gom9000/xp-bus-simplebus/interface-pic16f6x8/README.md

# xpSimpleBUS Interface to PIC16F6x8
Hardware and software to connect xpSimpleBUS to PIC16f6x8.

overview

## Hardware
[Hardware](hardware) to connect xpSimpleBUS to PIC16f6x8 through the *A/D Mux Bridge* board.

## Software
*todo...*
