gom9000/xp-bus-simplebus/interface-rpi/README.md

# xpSimpleBUS Interface to RPi
Software driver to connect xpSimpleBUS to RaspberryPi through the *A/D Mux Bridge* board.

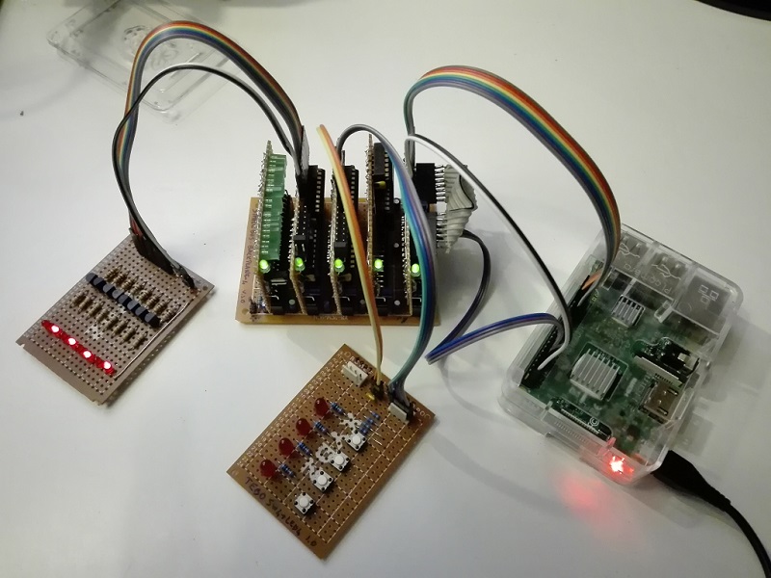
[picture p2: interface-rpi/simplebus-interface-rpi.jpg]
overview


## Software
* **xpSimpleBUS Diagnostic Tool**
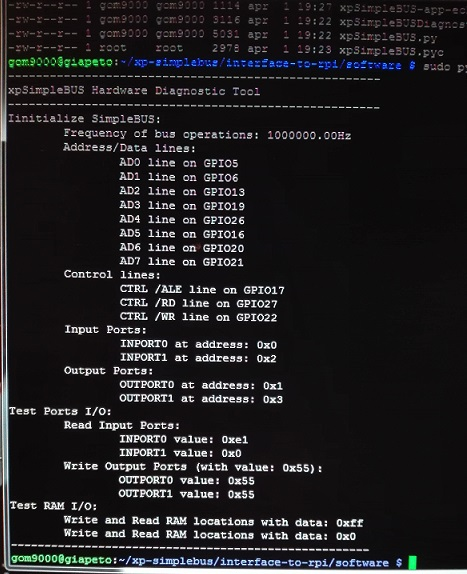
[picture p3: interface-rpi/simplebus-interface-rpi-diagnostic.jpg]
>
