gom9000/xp-bus-simplebus/bridge/README.md

# xpSimpleBUS Bridge
Schematics and pcb of the hardware bridges to interface xpSimpleBUS to a CPU or other BUS systems.

## Contents
* [A/D Mux Bridge](simplebus-bridge-admux) xpSimpleBUS bridge to an external 8-bit BUS
