gom9000/xp-bus-simplebus/device/README.md

# xpSimpleBUS Device
Schematics and pcb of the xpSimpleBUS devices hardware.

## Contents
* [Input Port](simplebus-device-input-port) 8-bit input port with selectable address
* [Output Port](simplebus-device-output-port) 8-bit latched output port with selectable address
* [128x8-Bytes Static RAM](simplebus-device-sram-128bytes) 128x8-Bytes Static RAM
