gom9000/xp-bus-simplebus/system/README.md

# xpSimpleBUS System
Schematics and pcb of the xpSimpleBUS system backplanes and activity-monitor hardware.

## Contents
* [Backplane 4+1 slots](simplebus-system-backplane-4) 4+1 slots backplane
* [Activity Monitor](simplebus-system-activity-monitor) monitor/test board for bus pins activity
* [2-Slot BUS Expansion](simplebus-system-bus-expansion) 2-slot bus expansion board
