gom9000/xp-bus-simplebus/bridge/simplebus-bridge-admux/README.md

# *A/D Mux Bridge* Board
Bridge board to connect the xpSimpleBUS to an external 8-bit BUS with multiplexed address and data lines.

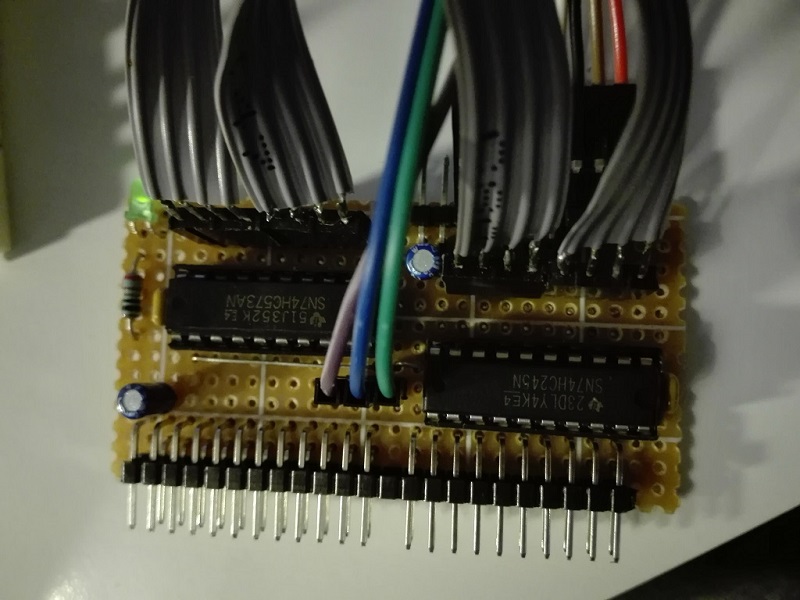
[picture p6: bridge/simplebus-bridge-admux/simplebus-bridge-admux_built.jpg]
board-built


## Schematic
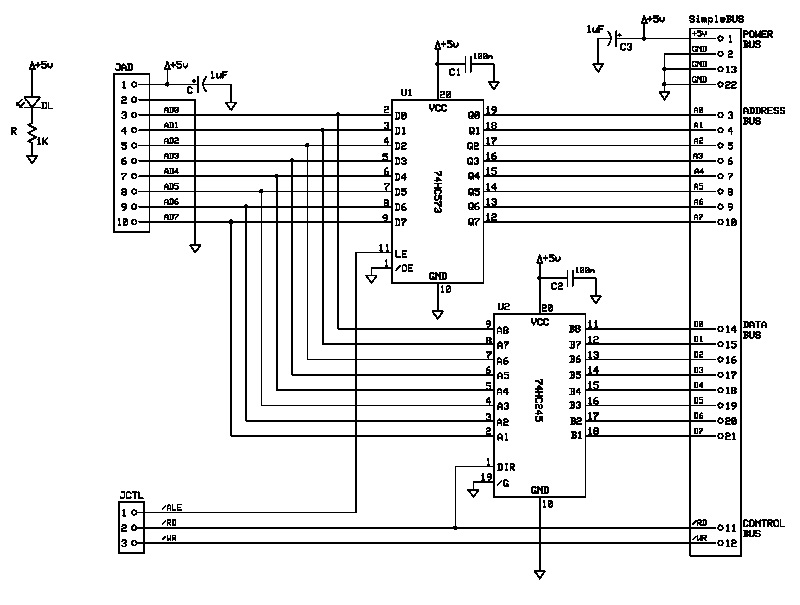
[picture p7: bridge/simplebus-bridge-admux/simplebus-bridge-admux_sch.jpg]
board-schematic


## PCB Layout
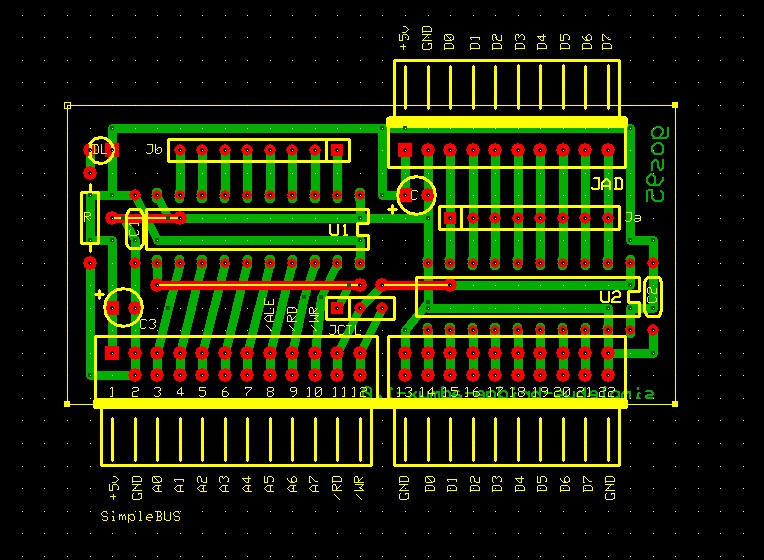
[picture p8: bridge/simplebus-bridge-admux/simplebus-bridge-admux_pcb.jpg]
board-pcb


## Bill of Materials
- [x] paperboard 5x7cm
- [x] 1 x bulk capacitors (tantalum) 1uF 16V
- [x] power activity led green 3mm
- [x] led current limiter resistor 1Kohm
- [x] SimpleBUS DIL 24-pin right-angle header

- [x] AD-BUS SIL 10-pin header
- [x] CTRL-BUS SIL 3-pin header
- [x] IC-logic 74HC573, 74HC245
