gom9000/xp-bus-simplebus/device/simplebus-device-output-port/README.md

# *Output Port* Board
8-bit latched output port with selectable address (by a 8-jumper row) in a range of 00H-07H.

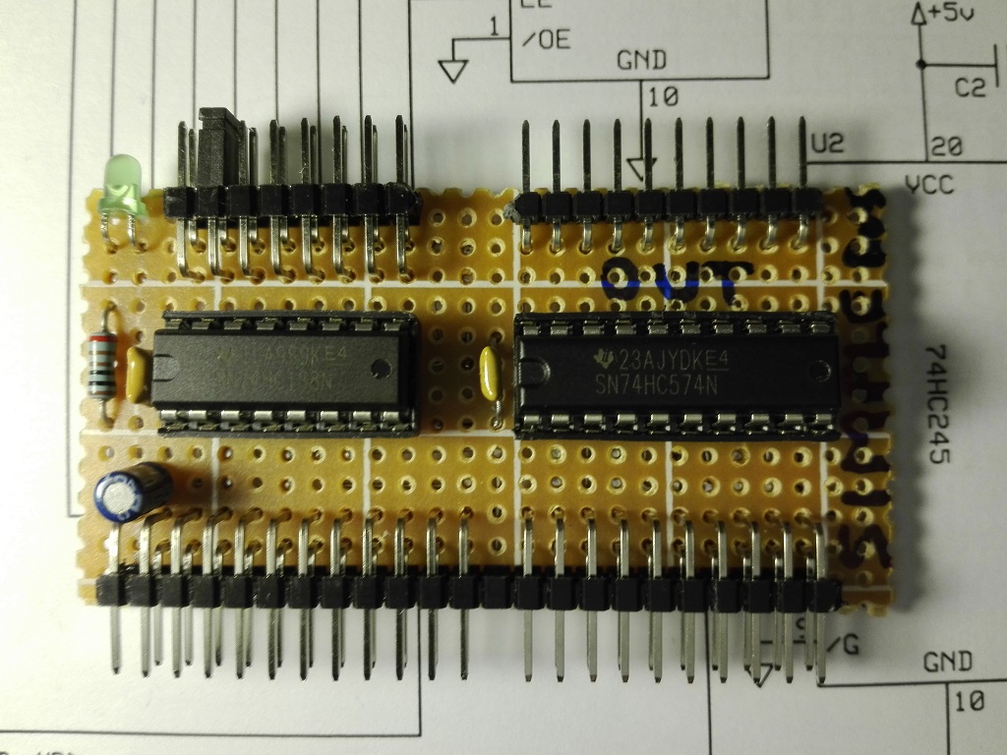
[picture p12: device/simplebus-device-output-port/simplebus-device-output-port_built.jpg]
board-built


## Schematic
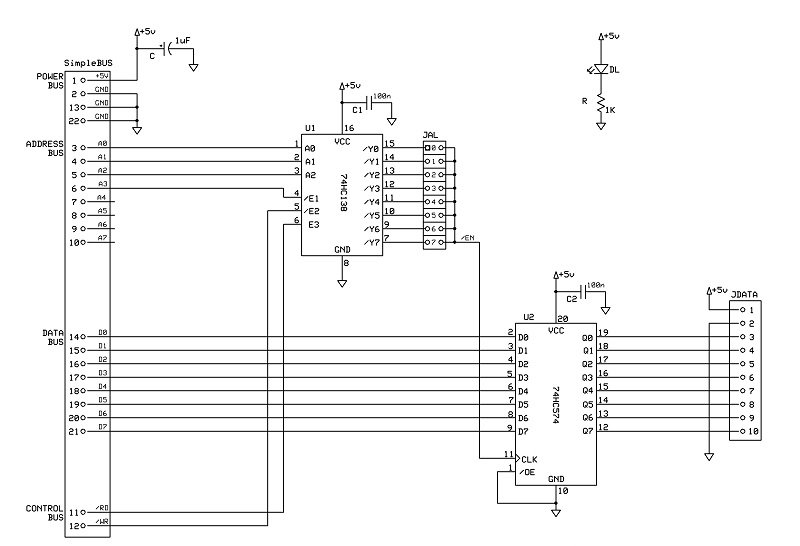
[picture p13: device/simplebus-device-output-port/simplebus-device-output-port_sch.jpg]
board-schematic


## PCB Layout
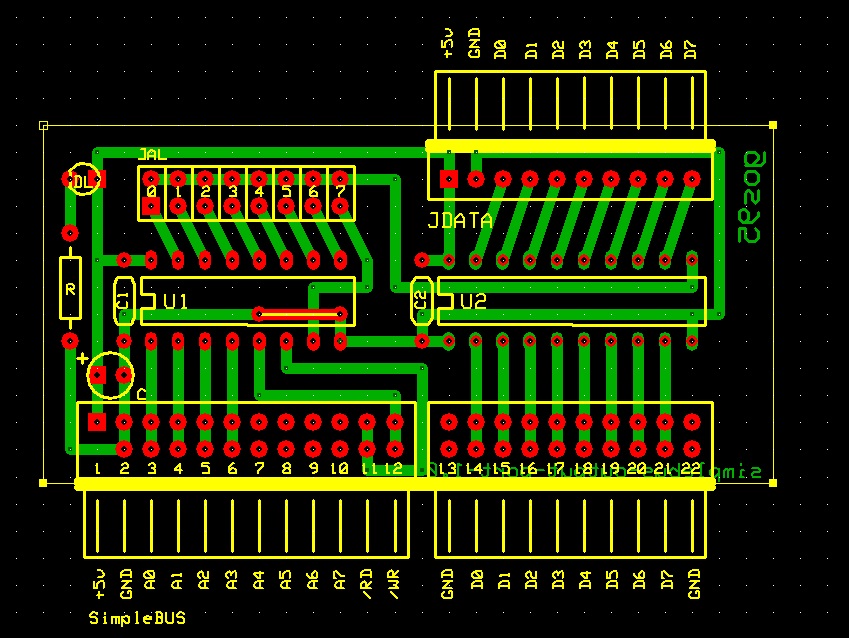
[picture p14: device/simplebus-device-output-port/simplebus-device-output-port_pcb.jpg]
board-pcb


## Bill of Materials
- [x] paperboard 5x7cm
- [x] 1 x bulk capacitors (tantalum) 1uF 16V
- [x] power activity led green 3mm
- [x] led current limiter resistor 1Kohm
- [x] SimpleBUS DIL 24-pin right-angle header

- [x] Address-Selector DIL 16-pin header
- [x] Output-BUS SIL 10-pin header
- [x] IC-logic 74HC573, 74HC574
