gom9000/xp-bus-simplebus/system/simplebus-system-activity-monitor/README.md

# *Activity Monitor* Board
Monitor/Test board for bus pins activity.

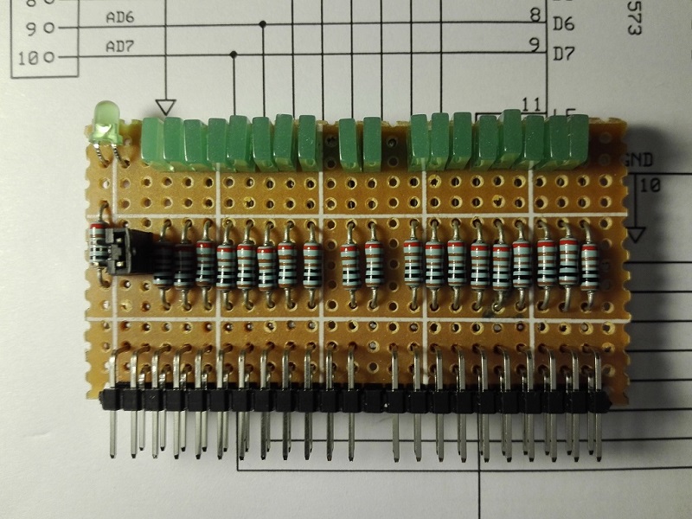
[picture p18: system/simplebus-system-activity-monitor/simplebus-activity-monitor_built.jpg]
board-built


## Schematic
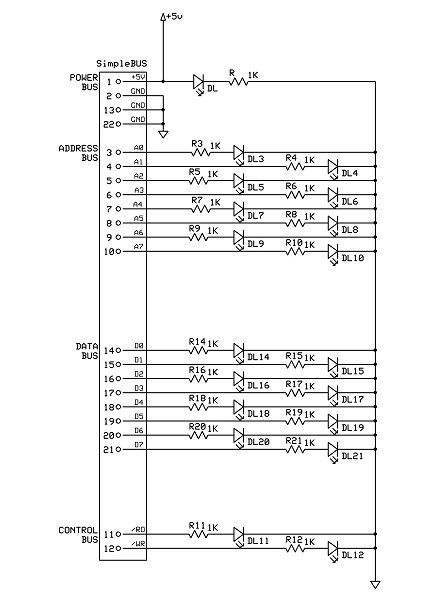
[picture p19: system/simplebus-system-activity-monitor/simplebus-activity-monitor_sch.jpg]
board-schematic


## PCB Layout
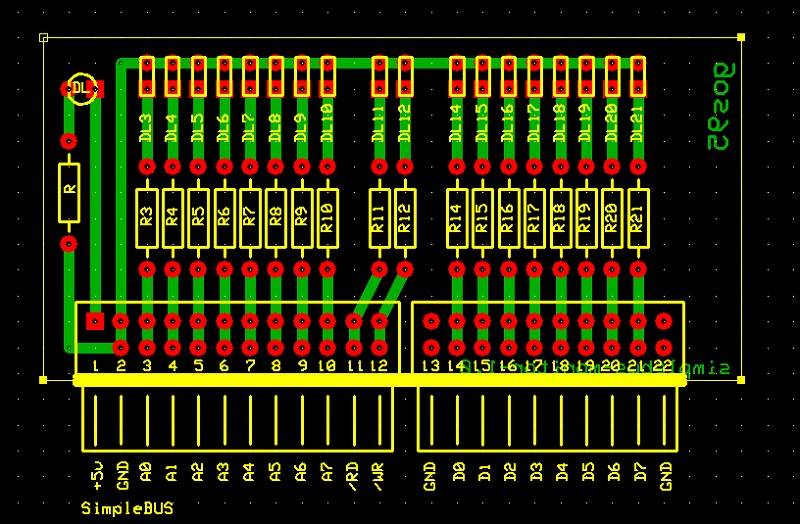
[picture p20: system/simplebus-system-activity-monitor/simplebus-activity-monitor_pcb.jpg]
board-pcb


## Bill of Materials
- [x] paperboard 5x7cm
- [x] power activity led green 3mm
- [x] led current limiter resistor 1Kohm
- [x] SimpleBUS DIL 24-pin right-angle header

- [x] 18x monitor led green 3mm
- [x] 18x monitor led current limiter resistor 1Kohm
