gom9000/xp-bus-simplebus/system/simplebus-system-backplane-4/README.md

# *Backplane 4+1 slots* Board
Backplane with 4+1 slots.

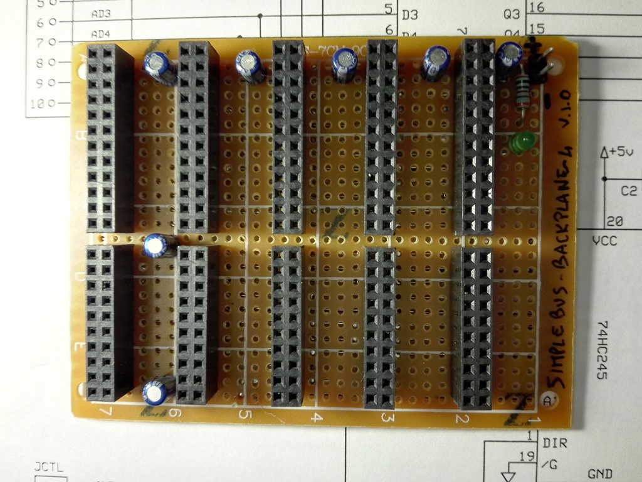
[picture p21: system/simplebus-system-backplane-4/simplebus-backplane-4_built.jpg]
board-built


## Schematic
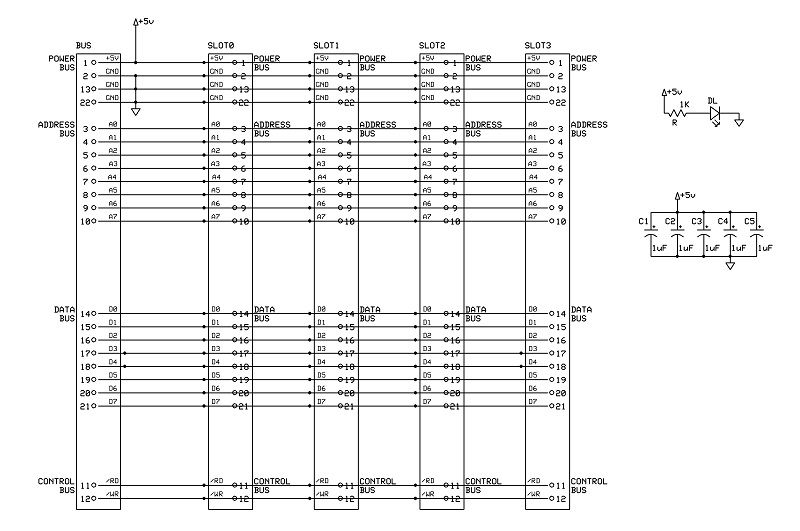
[picture p22: system/simplebus-system-backplane-4/simplebus-backplane-4_sch.jpg]
board-schematic


## PCB Layout
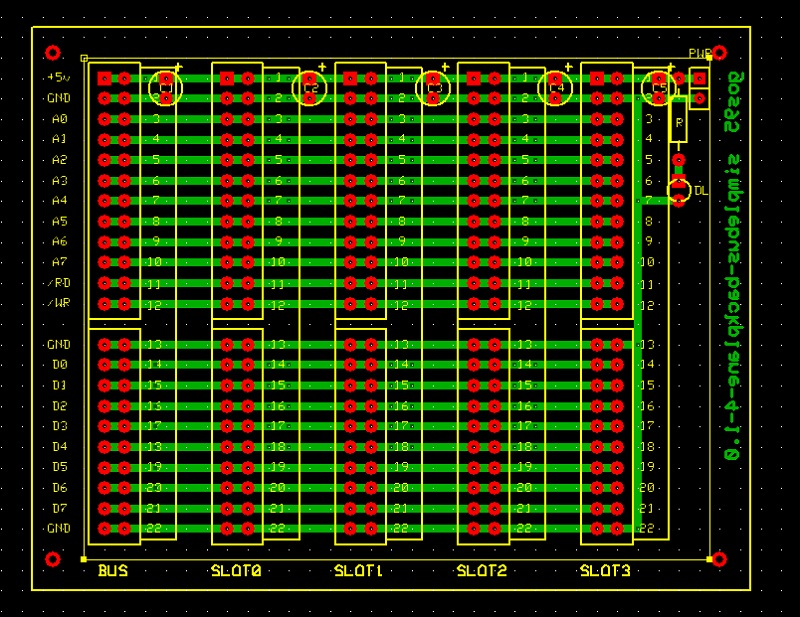
[picture p23: system/simplebus-system-backplane-4/simplebus-backplane-4_pcb.jpg]
board-pcb


## Bill of Materials
- [x] paperboard 7x10cm
- [x] 5 x bulk capacitors (tantalum) 1uF 16V
- [x] power activity led green 3mm
- [x] led current limiter resistor 1Kohm
- [x] 5x SimpleBUS DIL 24-pin female header

- [x] external power 2-pin header
