gom9000/xp-bus-simplebus/system/simplebus-system-bus-expansion/README.md

# *2-Slot BUS Expansion* Board
2-slot bus expansion.

board-built

## Schematic
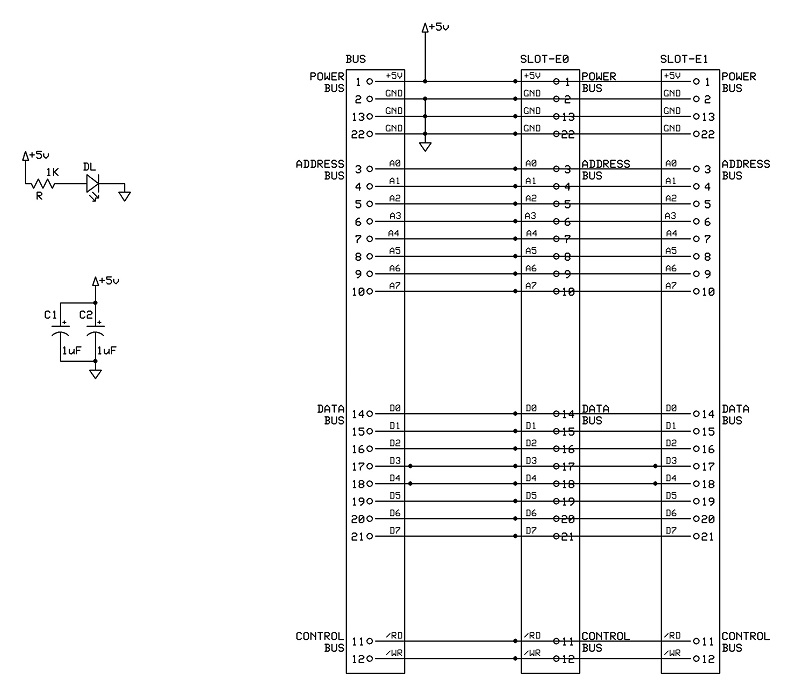
[picture p24: system/simplebus-system-bus-expansion/simplebus-bus-expansion_sch.jpg]
board-schematic


## PCB Layout
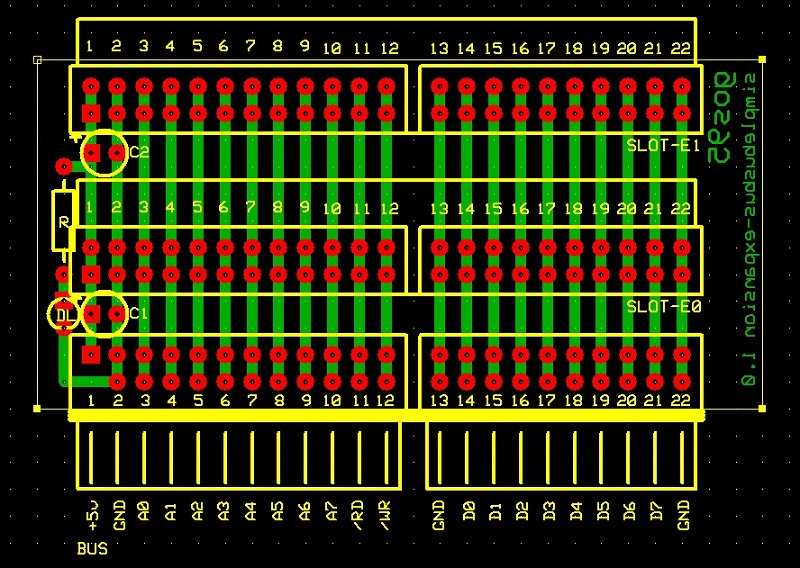
[picture p25: system/simplebus-system-bus-expansion/simplebus-bus-expansion_pcb.jpg]
board-pcb


## Bill of Materials
- [x] paperboard 5x7cm
- [x] 2 x bulk capacitors (tantalum) 1uF 16V
- [x] power activity led green 3mm
- [x] led current limiter resistor 1Kohm
- [x] SimpleBUS DIL 24-pin right-angle header
