gom9000/xp-bus-simplebus/images/simplebus-2.jpg

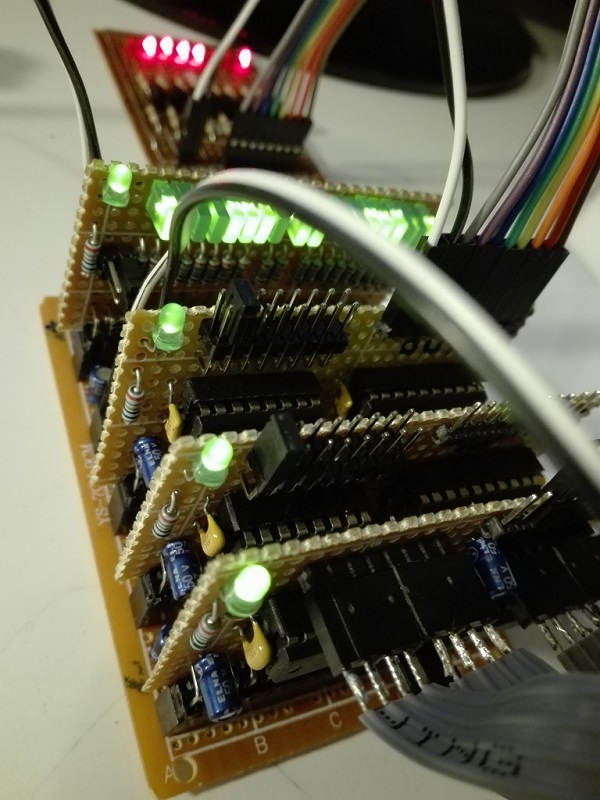
images/simplebus-2.jpg
