gom9000/xp-bus-simplebus/images/simplebus-parts-2.jpg

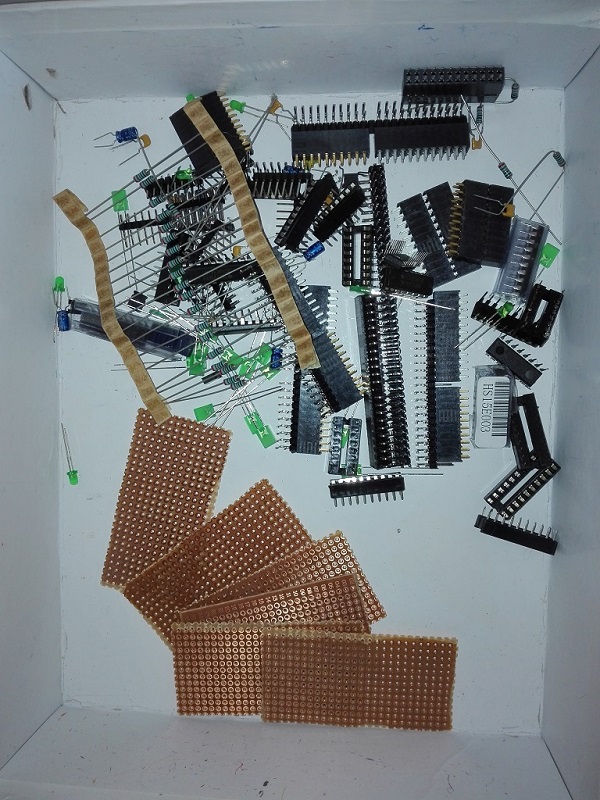
images/simplebus-parts-2.jpg
