gom9000/xp-bus-simplebus/images/simplebus-parts.jpg

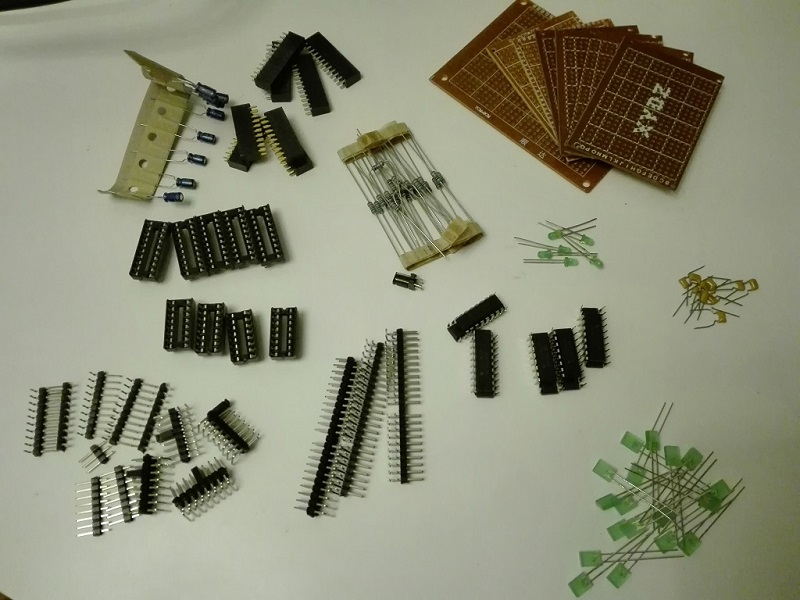
images/simplebus-parts.jpg
