gom9000/xp-bus-simplebus/(list of files, drawings)

Other design files:
bridge/simplebus-bridge-admux/simplebus-bridge-admux.pcb
device/simplebus-device-input-port/simplebus-device-input-port.pcb
device/simplebus-device-output-port/simplebus-device-output-port.pcb
device/simplebus-device-sram-128bytes/simplebus-device-sram-128bytes.pcb
expresspcb/simplebus-components.pcb
interface-pic16f6x8/hardware/simplebus-interface-16f6x8.pcb
system/simplebus-system-activity-monitor/simplebus-activity-monitor.pcb
system/simplebus-system-backplane-4/simplebus-backplane-4.pcb
system/simplebus-system-bus-expansion/simplebus-bus-expansion.pcb
