gom9000/xp-bus-simplebus/(commit log)

2019-04-01 add xp-simplebus schematics, pcbs, images and READMEs
    [simplebus-activity-monitor.pcb, simplebus-activity-monitor.sch, simplebus-backplane-4.pcb, simplebus-backplane-4.sch, simplebus-bridge-admux.pcb, simplebus-bridge-admux.sch, simplebus-components.pcb, simplebus-components.sch]
2019-04-01 add interface/rpi
    [simplebus-rpi-level-adapter.pcb, simplebus-rpi-level-adapter.sch]
2019-04-01 fix pcb connector labels
    [simplebus-rpi-level-adapter.pcb]
2019-04-03 fix interface/rpi stuff
    [simplebus-rpi-level-adapter.pcb, simplebus-rpi-level-adapter.sch]
2019-04-05 add simplebus-bus-expansion system board
    [simplebus-bus-expansion.pcb, simplebus-bus-expansion.sch]
2019-04-22 fix minors and dates
    [simplebus-bridge-admux.sch, simplebus-bus-expansion.sch]
2019-10-01 repo tree refactory
    [simplebus-bridge-admux.pcb, simplebus-bridge-admux.sch]
2019-10-31 add if-pic16f6x8
    [simplebus-interface-16f6x8.pcb, simplebus-interface-16f6x8.sch]
2019-11-04 add if-pic16f6x8 pcb layout
    [simplebus-interface-16f6x8.pcb, simplebus-interface-16f6x8.sch]
